Ejdmmm/MP/mat.prace_dokumentace/dokumentaceSchema01.png

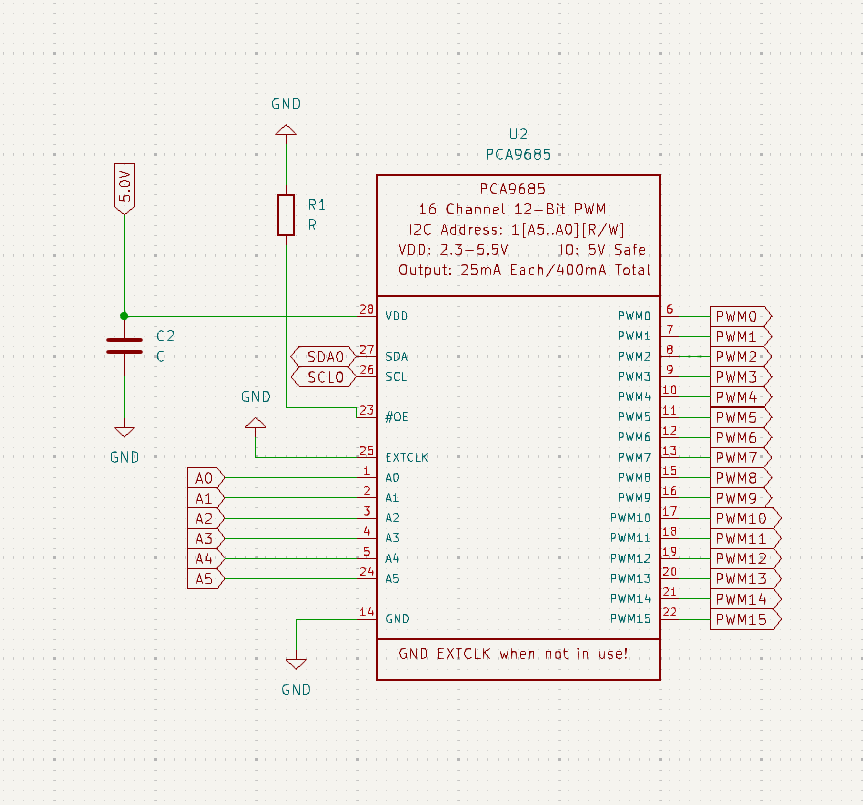
mat.prace_dokumentace/dokumentaceSchema01.png
