Ejdmmm/MP/mat.prace_dokumentace/dokumentaceSchemaDriverLeft.png

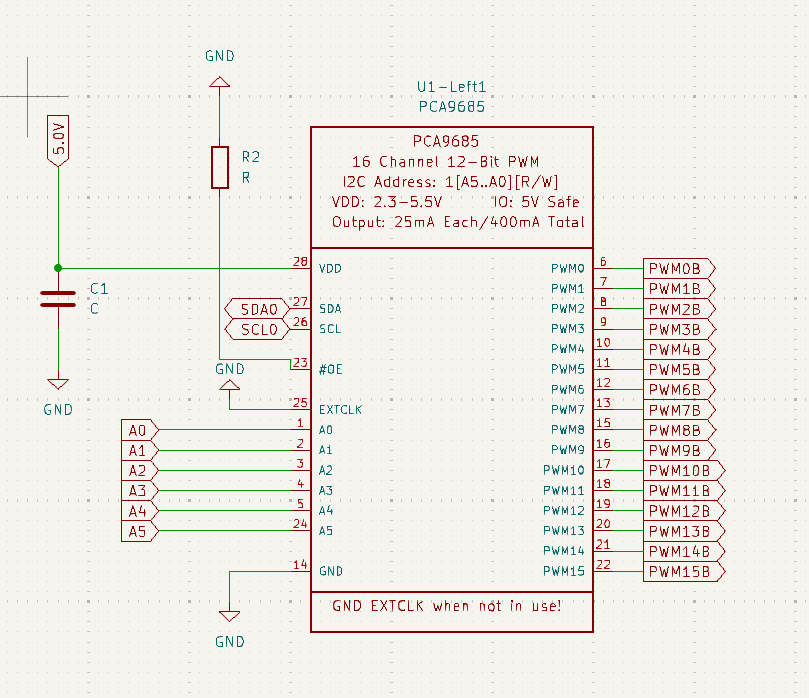
mat.prace_dokumentace/dokumentaceSchemaDriverLeft.png
