Ejdmmm/MP/mat.prace_dokumentace/dokumentaceSchemaDriverPiny.png

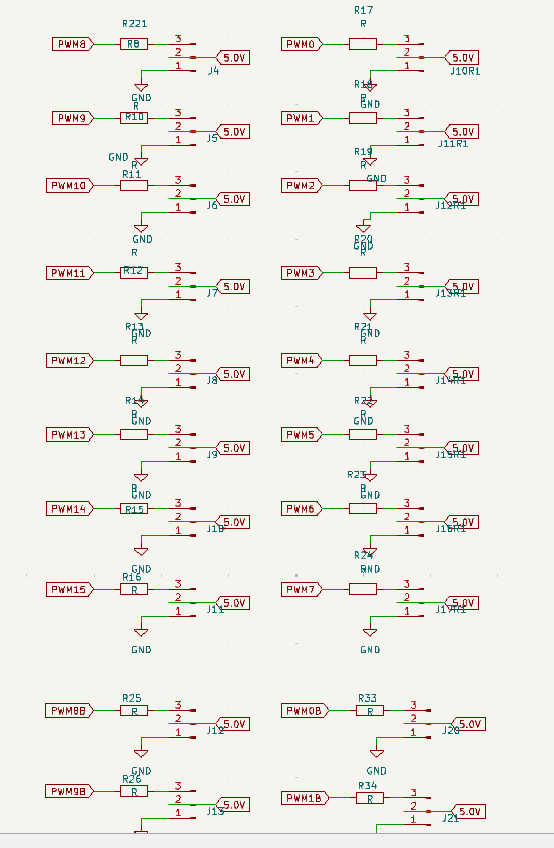
mat.prace_dokumentace/dokumentaceSchemaDriverPiny.png
