Ejdmmm/MP/mat.prace_dokumentace/Screenshot_1.png

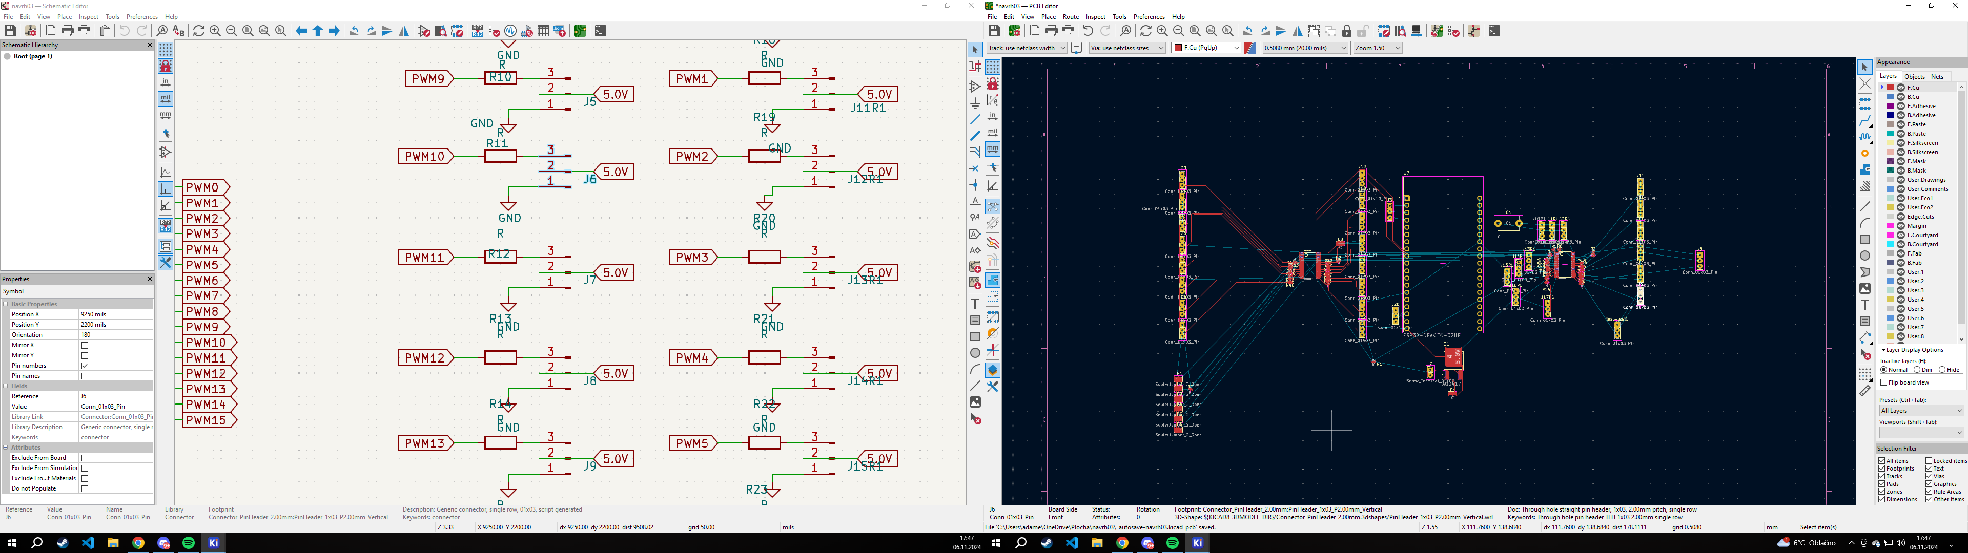
mat.prace_dokumentace/Screenshot_1.png
