Ejdmmm/MP/navrhAktualni/navrh03.pdf

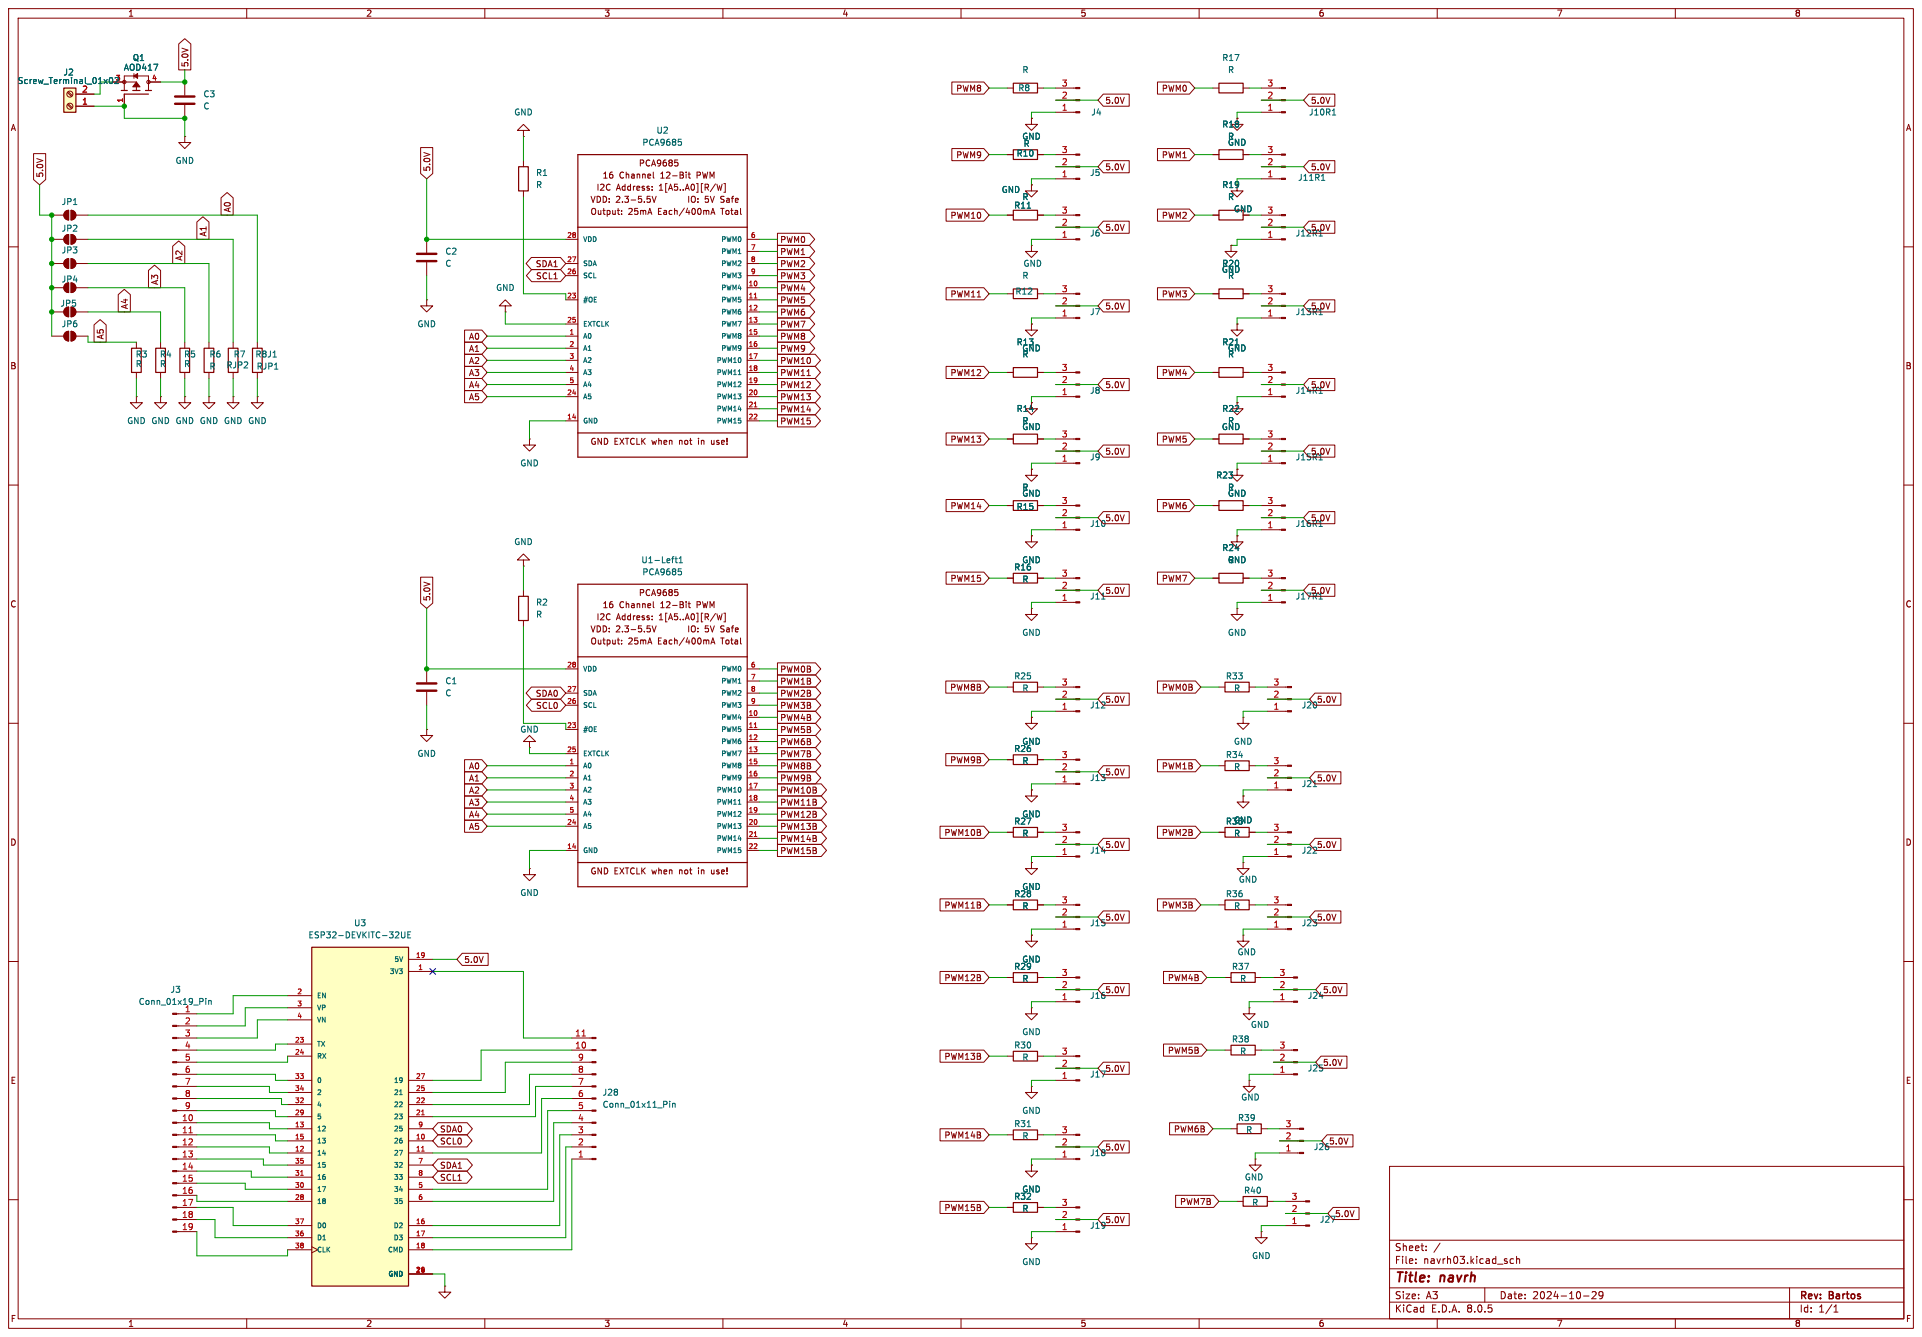
[picture p36: page 1]

GND EXTCLK when not in use!
