Ejdmmm/MP/navrhAktualni/navrh03.kicad_pcb

## KiCad design navrhAktualni/navrh03.kicad_pcb (2024-12-05)

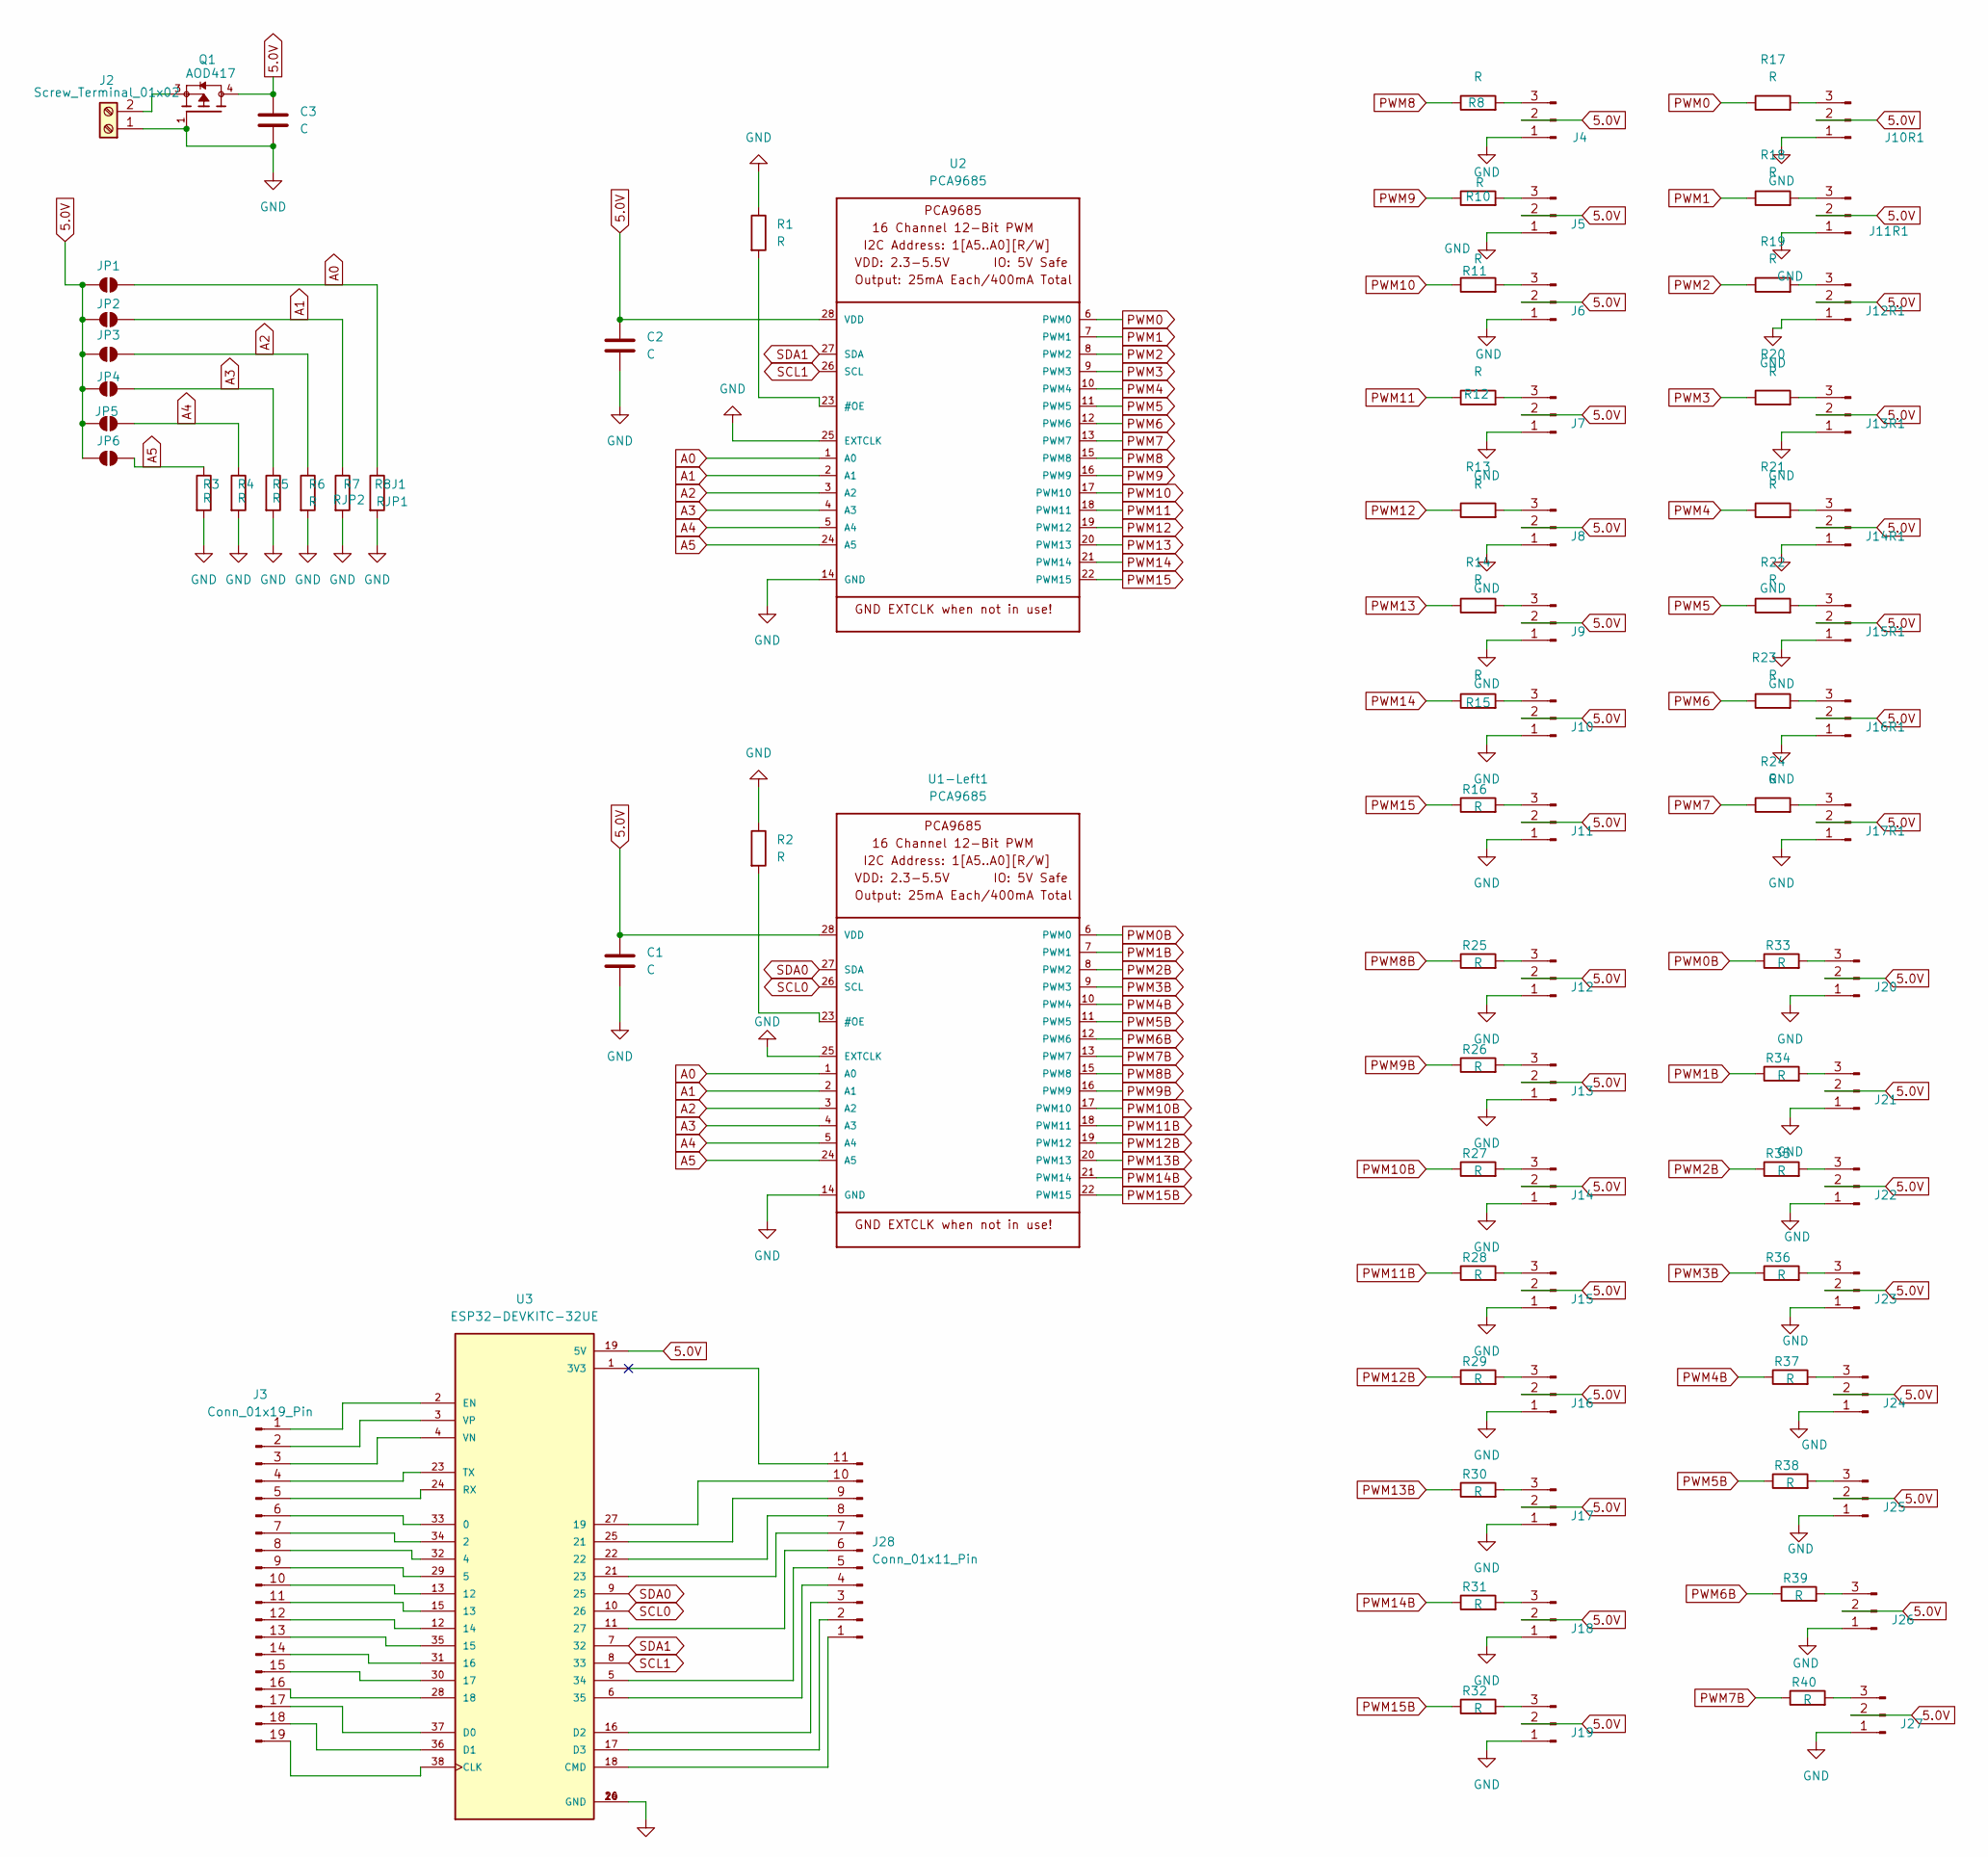
[picture p37: schematic navrh03.kicad_sch, navrh]

Parts:
C1: C; C_Disc_D7.5mm_W5.0mm_P7.50mm
C2, C3: C; CP_EIA-1608-08_AVX-J
J2: Screw_Terminal_01x02; PinHeader_1x02_P2.00mm_Vertical
J3: Conn_01x19_Pin; PinHeader_1x19_P2.00mm_Vertical
J4, J5, J6, J7, J8, J9, J10, J10R1, J11, J11R1, J12, J12R1, J13, J13R1, J14, J14R1, J15, J15R1, J16, J16R1, J17, J17R1, J18, J19, J20, J21, J22, J23, J24, J25, J26, J27: Conn_01x03_Pin; PinHeader_1x03_P2.00mm_Vertical
J28: Conn_01x11_Pin; PinHeader_1x11_P2.00mm_Vertical
JP1, JP2, JP3, JP4, JP5, JP6: SolderJumper_2_Open; SolderJumper-2_P1.3mm_Open_Pad1.0x1.5mm
Q1: AOD417; DPAK228P994X240_3N; PARTREV U
R1, R2, R3, R4, R5, R6, R8, R10, R11, R12, R13, R14, R15, R16, R17, R18, R19, R20, R21, R22, R23, R24, R25, R26, R27, R28, R29, R30, R31, R32, R33, R34, R35, R36, R37, R38, R39, R40: R; R_0201_0603Metric
R7: RJP2; R_0201_0603Metric
R8J1: RJP1; R_0201_0603Metric
U1-Left1, U2: PCA9685; TSSOP28
U3: ESP32-DEVKITC-32UE; ESPRESSIF_ESP32-DEVKITC-32UE; PARTREV V4

Connections:
A0: JP1.2 (B), R8J1.1, U1-Left1.1 (A0), U2.1 (A0)
A1: JP2.2 (B), R7.1, U1-Left1.2 (A1), U2.2 (A1)
A2: JP3.2 (B), R6.1, U1-Left1.3 (A2), U2.3 (A2)
A3: JP4.2 (B), R5.1, U1-Left1.4 (A3), U2.4 (A3)
A4: JP5.2 (B), R4.1, U1-Left1.5 (A4), U2.5 (A4)
A5: JP6.2 (B), R3.1, U1-Left1.24 (A5), U2.24 (A5)
unnamed: J2.2, Q1.3
unnamed: J3.1, U3.2 (EN)
unnamed: J3.2, U3.3 (VP)
unnamed: J3.3, U3.4 (VN)
unnamed: J3.4, U3.23 (TX)
unnamed: J3.5, U3.24 (RX)
unnamed: J3.6, U3.33 (0)
unnamed: J3.7, U3.34 (2)
unnamed: J3.8, U3.32 (4)
unnamed: J3.9, U3.29 (5)
unnamed: J3.10, U3.13 (12)
unnamed: J3.11, U3.15 (13)
unnamed: J3.12, U3.12 (14)
unnamed: J3.13, U3.35 (15)
unnamed: J3.14, U3.31 (16)
unnamed: J3.15, U3.30 (17)
unnamed: J3.16, U3.28 (18)
unnamed: J3.17, U3.37 (D0)
unnamed: J3.18, U3.36 (D1)
unnamed: J3.19, U3.38 (CLK)
unnamed: J4.3, R8.2
unnamed: J5.3, R10.2
unnamed: J6.3, R11.2
unnamed: J7.3, R12.2
unnamed: J8.3, R13.2
unnamed: J9.3, R14.2
unnamed: J10.3, R15.2
unnamed: J10R1.3, R17.2
unnamed: J11.3, R16.2
unnamed: J11R1.3, R18.2
unnamed: J12.3, R25.2
unnamed: J12R1.3, R19.2
unnamed: J13.3, R26.2
unnamed: J13R1.3, R20.2
unnamed: J14.3, R27.2
unnamed: J14R1.3, R21.2
unnamed: J15.3, R28.2
unnamed: J15R1.3, R22.2
unnamed: J16.3, R29.2
unnamed: J16R1.3, R23.2
unnamed: J17.3, R30.2
unnamed: J17R1.3, R24.2
unnamed: J18.3, R31.2
unnamed: J19.3, R32.2
unnamed: J20.3, R33.2
unnamed: J21.3, R34.2
unnamed: J22.3, R35.2
unnamed: J23.3, R36.2
unnamed: J24.3, R37.2
unnamed: J25.3, R38.2
unnamed: J26.3, R39.2
unnamed: J27.3, R40.2
unnamed: J28.1, U3.18 (CMD)
unnamed: J28.2, U3.17 (D3)
unnamed: J28.3, U3.16 (D2)
unnamed: J28.4, U3.6 (35)
unnamed: J28.5, U3.5 (34)
unnamed: J28.6, U3.11 (27)
unnamed: J28.7, U3.21 (23)
unnamed: J28.8, U3.22
unnamed: J28.9, U3.25 (21)
unnamed: J28.10, U3.27 (19)
unnamed: R2.2, U1-Left1.23 (#OE)
unnamed: R1.2, U2.23 (#OE)
PWM0: R17.1, U2.6 (PWM0)
PWM0B: R33.1, U1-Left1.6 (PWM0)
PWM1: R18.1, U2.7 (PWM1)
PWM1B: R34.1, U1-Left1.7 (PWM1)
PWM2: R19.1, U2.8 (PWM2)
PWM2B: R35.1, U1-Left1.8 (PWM2)
PWM3: R20.1, U2.9 (PWM3)
PWM3B: R36.1, U1-Left1.9 (PWM3)
PWM4: R21.1, U2.10 (PWM4)
PWM4B: R37.1, U1-Left1.10 (PWM4)
PWM5: R22.1, U2.11 (PWM5)
PWM5B: R38.1, U1-Left1.11 (PWM5)
PWM6: R23.1, U2.12 (PWM6)
PWM6B: R39.1, U1-Left1.12 (PWM6)
PWM7: R24.1, U2.13 (PWM7)
PWM7B: R40.1, U1-Left1.13 (PWM7)
PWM8: R8.1, U2.15 (PWM8)
PWM8B: R25.1, U1-Left1.15 (PWM8)
PWM9: R10.1, U2.16 (PWM9)
PWM9B: R26.1, U1-Left1.16 (PWM9)
PWM10: R11.1, U2.17 (PWM10)
PWM10B: R27.1, U1-Left1.17 (PWM10)
PWM11: R12.1, U2.18 (PWM11)
PWM11B: R28.1, U1-Left1.18 (PWM11)
PWM12: R13.1, U2.19 (PWM12)
PWM12B: R29.1, U1-Left1.19 (PWM12)
PWM13: R14.1, U2.20 (PWM13)
PWM13B: R30.1, U1-Left1.20 (PWM13)
PWM14: R15.1, U2.21 (PWM14)
PWM14B: R31.1, U1-Left1.21 (PWM14)
PWM15: R16.1, U2.22 (PWM15)
PWM15B: R32.1, U1-Left1.22 (PWM15)
SCL0: U1-Left1.26 (SCL), U3.10 (26)
SCL1: U2.26 (SCL), U3.8 (33)
SDA0: U1-Left1.27 (SDA), U3.9 (25)
SDA1: U2.27 (SDA), U3.7 (32)

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
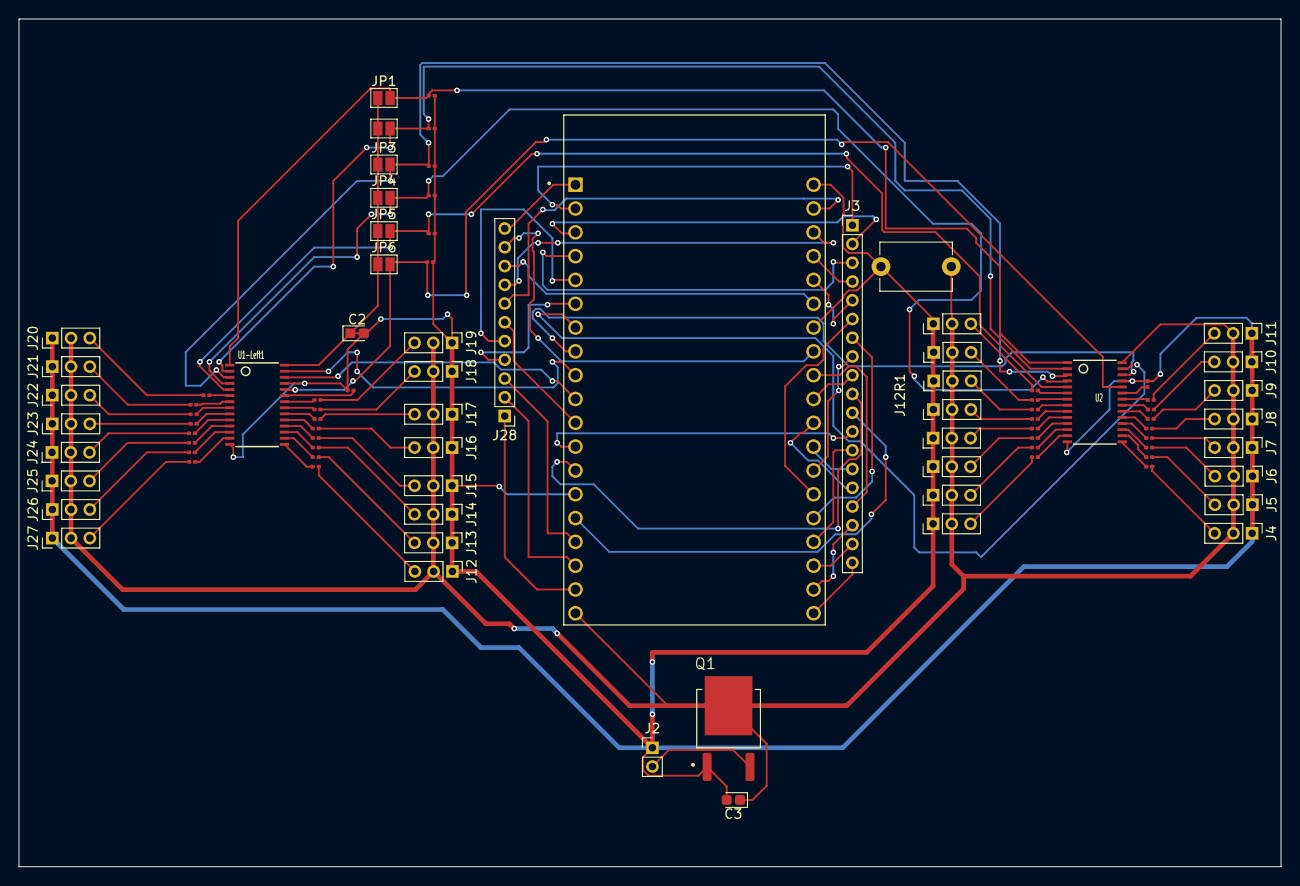
[picture p38: board navrh03.kicad_pcb from above]

Board: 2 copper layers, 134.6 x 90.4 mm, 88 parts (0 on the bottom side), 108 nets.
