Ejdmmm/MP/MP/myPCB_01.kicad_pcb

## KiCad design MP/myPCB_01.kicad_pcb (2024-10-18)

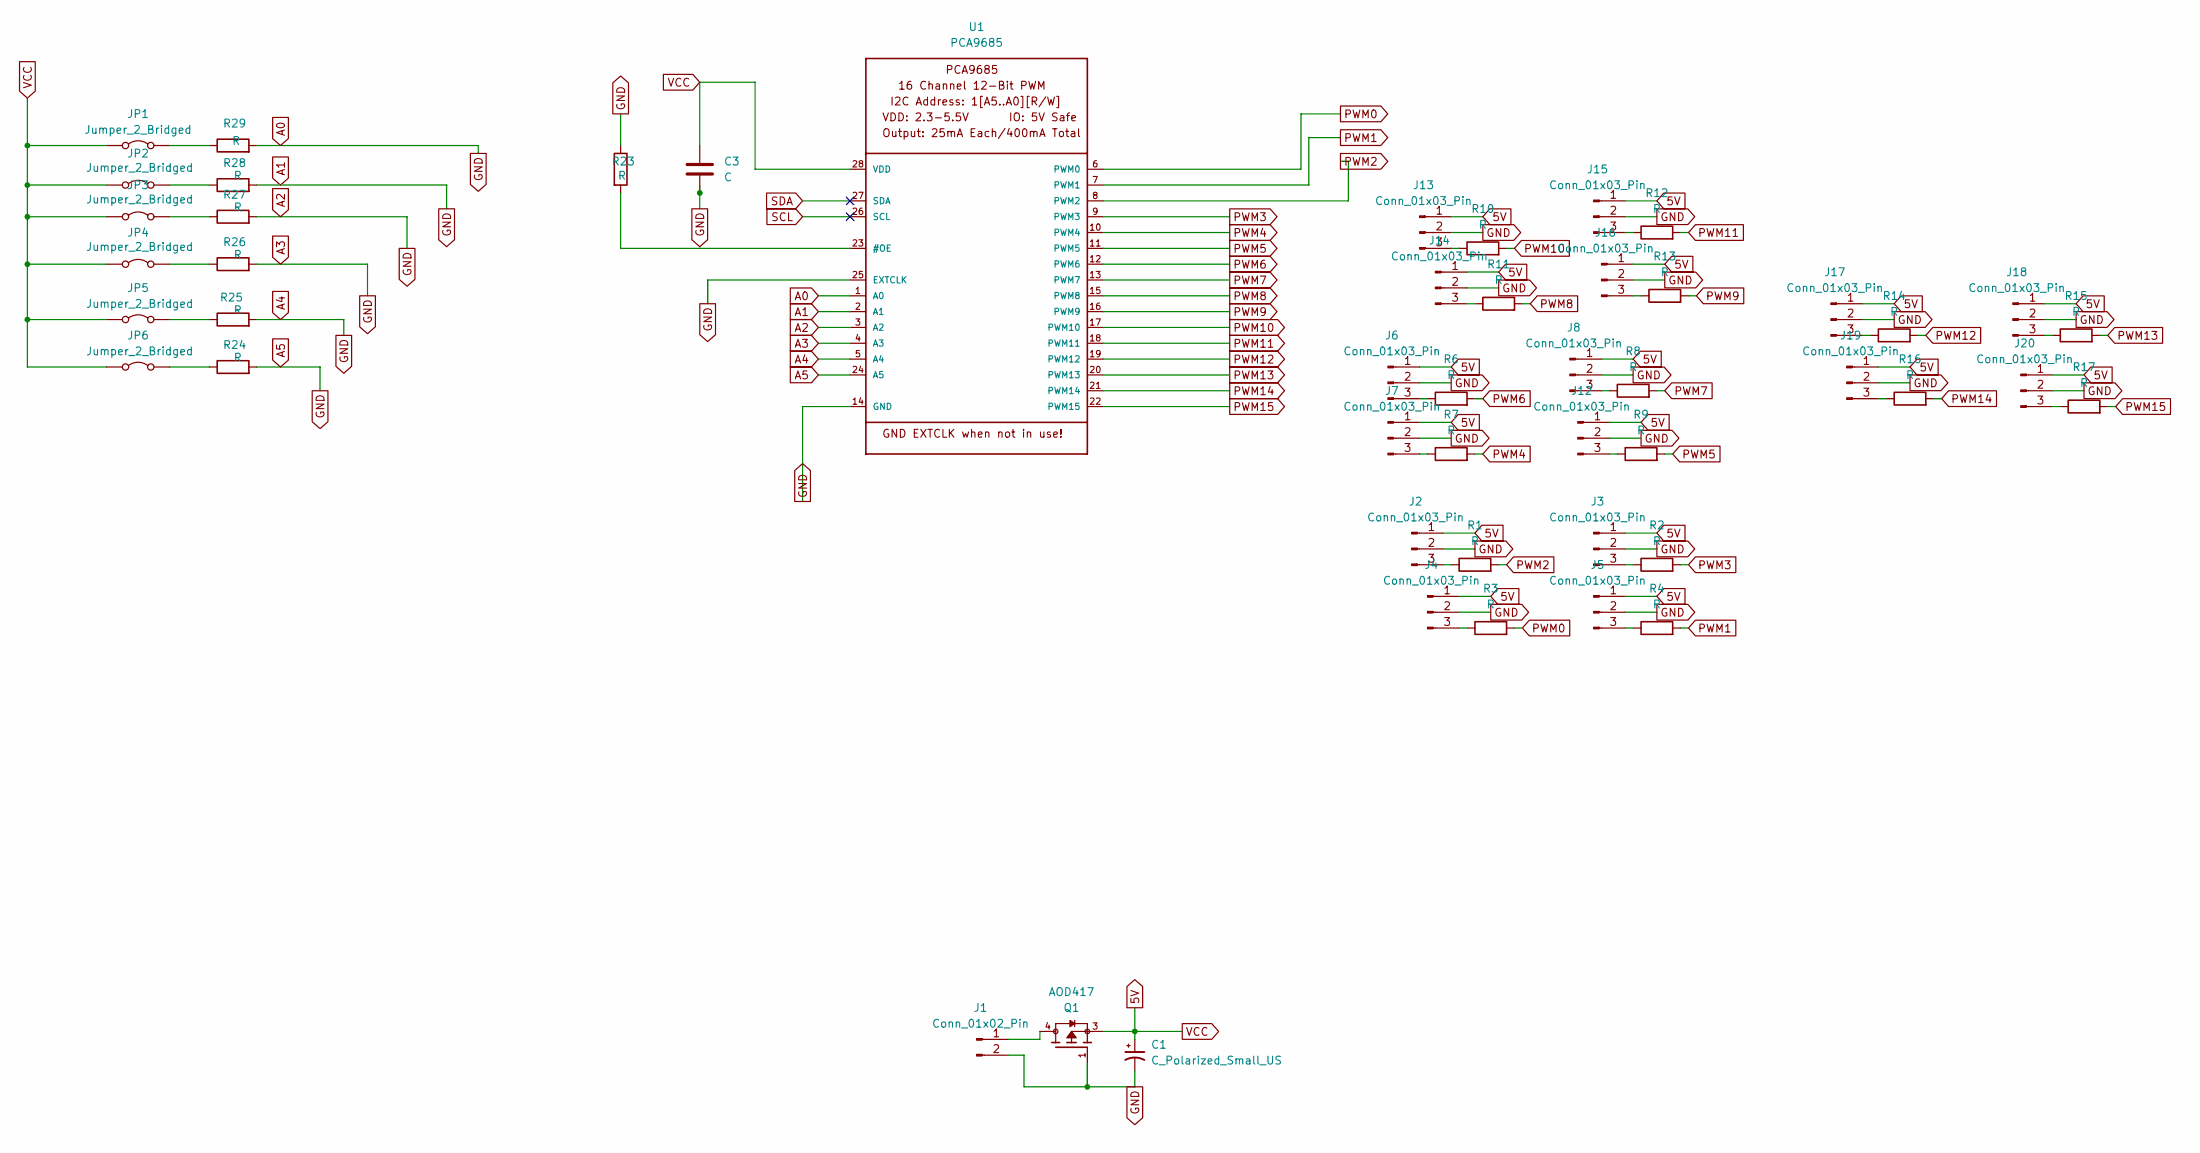
[picture p39: schematic myPCB_01.kicad_sch, MY PCA9685]

Parts:
C1: C_Polarized_Small_US; CP_Radial_D7.5mm_P2.50mm
C3: C; CP_Axial_L10.0mm_D4.5mm_P15.00mm_Horizontal
J1: Conn_01x02_Pin; PinHeader_1x02_P1.00mm_Vertical
J2, J3, J4, J5, J6, J7, J8, J12, J13, J14, J15, J16, J17, J18, J19, J20: Conn_01x03_Pin; PinHeader_1x03_P2.00mm_Vertical
JP1, JP2, JP3, JP4, JP5, JP6: Jumper_2_Bridged; SolderJumper-2_P1.3mm_Bridged2Bar_Pad1.0x1.5mm
Q1: AOD417; DPAK228P994X240_3N; PARTREV U
R1, R2, R3, R4, R6, R7, R8, R9, R10, R11, R12, R13, R14, R15, R16, R17, R23, R24, R25, R26, R27, R28, R29: R; R_0201_0603Metric
U1: PCA9685; TSSOP28

Connections:
5V: C1.1, C3.1, J2.1, J3.1, J4.1, J5.1, J6.1, J7.1, J8.1, J12.1, J13.1, J14.1, J15.1, J16.1, J17.1, J18.1, J19.1, J20.1, JP1.1 (A), JP2.1 (A), JP3.1 (A), JP4.1 (A), JP5.1 (A), JP6.1 (A), Q1.3, U1.28 (VDD)
A0: C1.2, C3.2, J1.2, J2.2, J3.2, J4.2, J5.2, J6.2, J7.2, J8.2, J12.2, J13.2, J14.2, J15.2, J16.2, J17.2, J18.2, J19.2, J20.2, Q1.1, R23.1, R24.2, R25.2, R26.2, R27.2, R28.2, R29.2, U1.1 (A0), U1.2 (A1), U1.3 (A2), U1.4 (A3), U1.5 (A4), U1.14 (GND), U1.24 (A5), U1.25 (EXTCLK)
unnamed: J1.1, Q1.4
unnamed: J2.3, R1.1
unnamed: J3.3, R2.1
unnamed: J4.3, R3.1
unnamed: J5.3, R4.1
unnamed: J6.3, R6.1
unnamed: J7.3, R7.1
unnamed: J8.3, R8.1
unnamed: J12.3, R9.1
unnamed: J13.3, R10.1
unnamed: J14.3, R11.1
unnamed: J15.3, R12.1
unnamed: J16.3, R13.1
unnamed: J17.3, R14.1
unnamed: J18.3, R15.1
unnamed: J19.3, R16.1
unnamed: J20.3, R17.1
unnamed: JP1.2 (B), R29.1
unnamed: JP2.2 (B), R28.1
unnamed: JP3.2 (B), R27.1
unnamed: JP4.2 (B), R26.1
unnamed: JP5.2 (B), R25.1
unnamed: JP6.2 (B), R24.1
unnamed: R23.2, U1.23 (#OE)
PWM0: R3.2, U1.6 (PWM0)
PWM1: R4.2, U1.7 (PWM1)
PWM2: R1.2, U1.8 (PWM2)
PWM3: R2.2, U1.9 (PWM3)
PWM4: R7.2, U1.10 (PWM4)
PWM5: R9.2, U1.11 (PWM5)
PWM6: R6.2, U1.12 (PWM6)
PWM7: R8.2, U1.13 (PWM7)
PWM8: R11.2, U1.15 (PWM8)
PWM9: R13.2, U1.16 (PWM9)
PWM10: R10.2, U1.17 (PWM10)
PWM11: R12.2, U1.18 (PWM11)
PWM12: R14.2, U1.19 (PWM12)
PWM13: R15.2, U1.20 (PWM13)
PWM14: R16.2, U1.21 (PWM14)
PWM15: R17.2, U1.22 (PWM15)
SCL: U1.26 (SCL)
SDA: U1.27 (SDA)

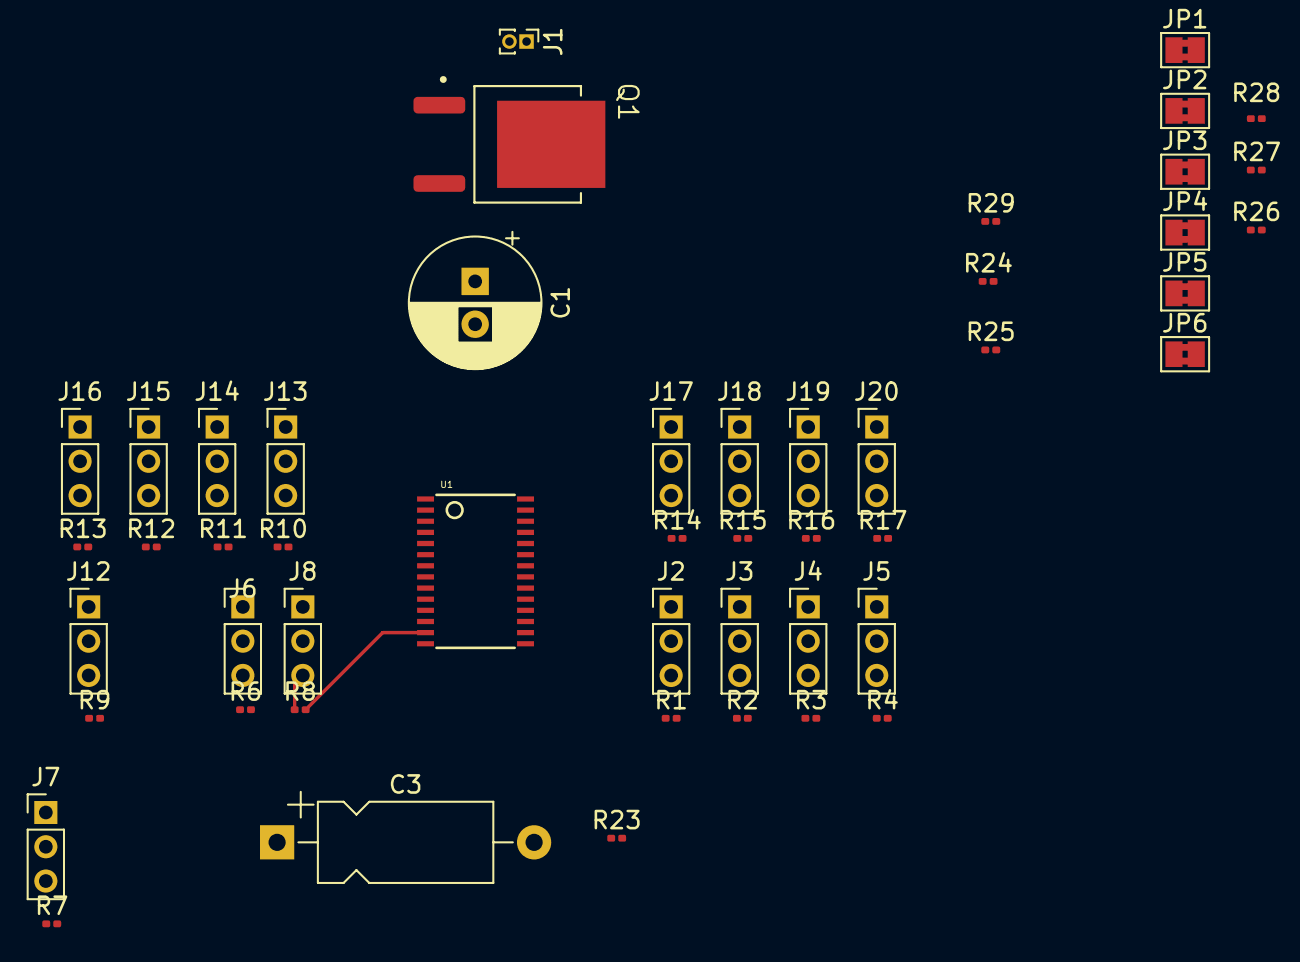
[picture p40: board myPCB_01.kicad_pcb from above]

Board: 2 copper layers, 50 parts (0 on the bottom side), 42 nets.
