Ejdmmm/MP/(commit log)

2024-11-08 Add files via upload
    Try to wire jumpers etc.
    [navrh03.kicad_pcb, navrh03.kicad_sch]
2024-11-24 NavrhMP check
    [navrh03-B_Cu.gbr, navrh03-B_Mask.gbr, navrh03-B_Paste.gbr, navrh03-B_Silkscreen.gbr, navrh03-Edge_Cuts.gbr, navrh03-F_Cu.gbr, navrh03-F_Mask.gbr, navrh03-F_Paste.gbr]
